gabgari/SHADOWBOT-codigo/docs/comandos-del-mando.pdf

# S H A D O W B O T

COMANDOS DEL MANDO · DUALSHOCK 4

Todos los botones, combinaciones y comandos por modo del mando de PS4 conectado al teléfono (Bluetooth o USB). La app los ejecuta y se los manda al carrito; no hay que cargar código en ninguna placa.

Cómo leer esta guía. L2 + botón = mantén L2 apretado y presiona el otro botón (combo). 2x = dos toques rápidos (menos de 0.4 s entre ellos). Los comandos solo funcionan después de presionar INICIAR en Conexiones; antes de eso el mando vibra y la bitácora dice "Bloqueado". El único que funciona siempre es PS = paro de emergencia. Los combos se pueden desactivar en la pantalla Mando › "Combos (L2 + botón)".

L1 no se usa. Está prohibido a propósito: no tiene ninguna función para evitar errores.

## 01 SIEMPRE (EN CUALQUIER MODO)

Botón | Qué hace
Stick izquierdo | Manejar el carrito (analógico: acelerar + girar). La velocidad tope es la misma del slider VELOCIDAD de la app.
Stick derecho | Mover el brazo de la cámara como torreta (PAN izquierda/derecha, TILT arriba/abajo), con arranque y frenado suaves.
PS | PARO DE EMERGENCIA: frena motores, corta bailes y escaneos. Destello rojo + vibración fuerte. Funciona aunque esté bloqueado.
Share | Tomar FOTO de la cámara principal (con su filtro). Destello blanco.
L2 + Share NUEVO | GRABAR / DETENER VIDEO. Graba la cámara principal, o las 2 cámaras juntas en un solo video si está activo 2 CAM en la consola.
Options | Entrar / salir de PANTALLA COMPLETA.
R3 (clic stick der.) | Centrar el brazo (a su posición 0).
L3 (clic stick izq.) | Escaneo panorámico con el brazo: izquierda, derecha y vuelve al centro.
2x R1 | Entrar al modo que se ve en el carrusel del menú.
2x R2 NUEVO | GIRO DE 360° sobre su propio eje (otra vez 2x R2 = cancelar). Usa los segundos por vuelta de Sistema › Exploración autónoma.
2x L2 (toques cortos) | Salir al MENÚ. Solo cuenta si no hiciste un combo con L2 de por medio.

## 02 COMBOS CON L2 MANTENIDO

L2 + Share NUEVO | Grabar / detener video (ver arriba).
L2 + ✕ | Faros: prender / apagar los 4 LEDs juntos.
L2 + ○ | Retroceso corto (0.6 s hacia atrás).
L2 + □ | Siguiente filtro de la cámara principal (Normal → IR → B/N → Verde → …).
L2 + △ | Analizar lo que ve la cámara principal con IA (Gemini).
L2 + ↑ | Brazo a la posición A (si está vacía, guarda ahí la posición actual).
L2 + → | Brazo a la posición B (vacía = la guarda).
L2 + ↓ | Brazo a la posición C (vacía = la guarda).
L2 + ← | Centrar el brazo.
L2 + R1 | Cambiar la cámara principal CAM 1 ↔ CAM 2.
L2 + R2 | Ir a la siguiente sección de la app (sale de pantalla completa si estaba abierta).
L2 + Options | Prender / apagar la luz del LCD 16x2 de CONTROL.
L2 + L3 | Bajar la velocidad del carrito 10 % (mínimo 10 %). Es la misma velocidad del slider de la app.
L2 + R3 | Subir la velocidad del carrito 10 % (máximo 100 %). Vibra más fuerte a más velocidad.

## 03 SEGÚN EL MODO DEL CARRITO

MENÚ (CARRUSEL)
← / → | Página anterior / siguiente del carrusel.
✕ | Entrar al modo que se ve.
- □ △ | LED 2, 3 y 4.
Stick izq. | El carrito también se maneja en el menú.
↑↑↓↓←→←→ ○ ✕ | Código secreto: MODO FIESTA (entra a DANCE con Everybody y luz de fiesta 22 s).

SPORT
✕ ○ □ △ | LED 1, 2, 3 y 4.
Stick izq. | Manejo tipo carrito RC, a la velocidad
| de la app.
Luz | Fuego que alterna | azul y | rojo.

EXPLORACIÓN (INSPECCIÓN)
✕ ○ □ △ | LED 1, 2, 3 y 4.
↑ / ↓ | Subir / bajar la velocidad de
EXPLORACIÓN (20–100 %, se ve en el LCD).
← / → | La cámara mira a la izquierda /
derecha.
R2 mantenido Modo preciso: 35 % de velocidad mientras lo aprietes.
Luz | Semáforo del gas MQ-2: | verde < 20
%, | amarillo 20–35 %, | rojo > 35 %
(vibra al entrar a rojo).

JUEGO / DANCE
✕ | Baile GIRO LOCO.
- Baile ZIGZAG.
□ | Baile SÍ Y NO.
△ | Baile TWIST.
← | Everybody (con música en el teléfono).
→ | Tokyo Drift (con música en el teléfono).
↓ | Parar el baile.

## 04 LUZ Y VIBRACIÓN DEL MANDO

Situación | Respuesta del mando
Por defecto | Fuego rojo animado (más vivo en SPORT y DANCE). En la pantalla Mando puedes elegir otro color, rojo fijo por modo o apagarla.
SPORT | Azul y rojo alternados (se desactiva con "SPORT en azul y rojo").
EXPLORACIÓN | Verde / amarillo / rojo según el MQ-2 (necesita la placa de sensores vinculada; se desactiva con "Luz según el gas").
Bailes | Vibra y destella en colores al ritmo de cada paso.
Al conectar | Destello rojo + vibración.
Cambio de modo | Destello + vibración corta.
Foto / Video | Destello blanco (foto) o rojo (video) + vibración.
Paro (PS) | Destello rojo largo + vibración fuerte.

## 05 AJUSTES EN LA PANTALLA MANDO

Ajuste | Para qué sirve
Velocidad del carrito | La misma velocidad de la app (también L2 + L3 / R3).
Zona muerta | Cuánto hay que mover los sticks antes de que respondan (5–30 %).
Velocidad brazo | Qué tan rápido se mueve el brazo con el stick derecho.
Invertir brazo | Stick derecho arriba/abajo al revés (como avión).
Vibración / Baile | Prender o apagar la vibración de avisos y la del ritmo de los bailes.
Luz del mando | Fuego rojo, rojo fijo por modo, apagada o fuego de un color.
| SHADOW BOT · BY GABGARI · COMANDOS DEL MANDO · OCTUBRE 2026
