gabgari/SHADOWBOT-codigo/docs/diagrama-de-conexiones.pdf

## A ESP32-S3 CONTROL · MOTORES, BRAZO Y LCD

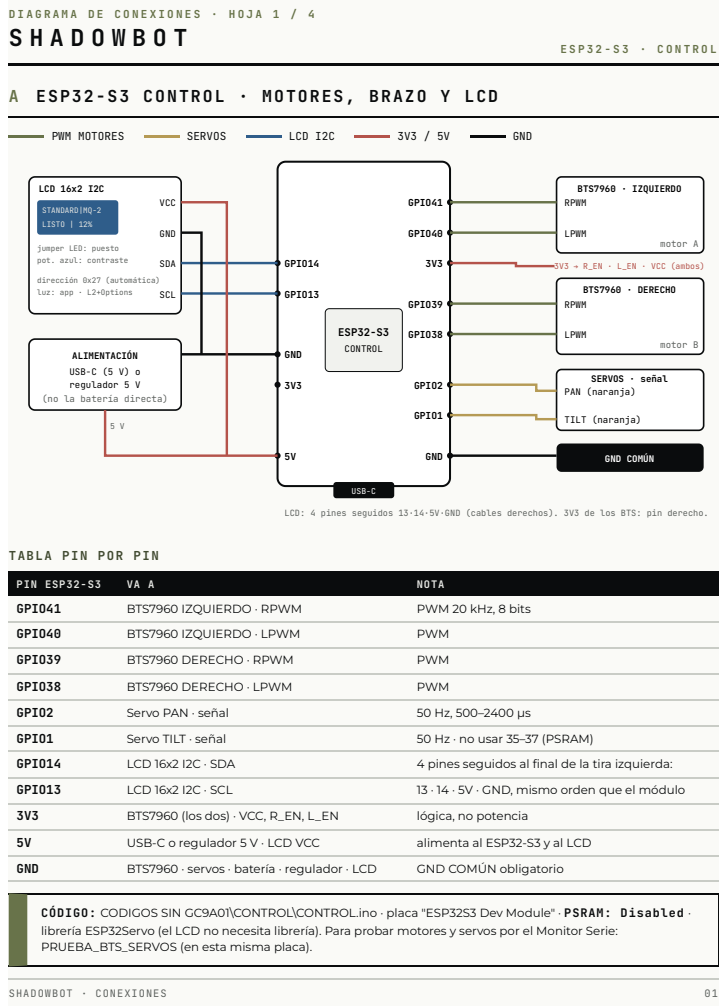
[picture p13: page 1]
PWM MOTORES; SERVOS; LCD I2C; GND; USB-C; ESP32-S3; CONTROL; GPIO14; GPIO13; GPIO41; GPIO40; GPIO39; GPIO38; GPIO2; GPIO1; LCD 16x2 I2C; STANDARD|MQ-2 LISTO | 12%; VCC; SDA; SCL; BTS7960 · IZQUIERDO RPWM; LPWM; motor A; BTS7960 · DERECHO RPWM; motor B; SERVOS · señal PAN (naranja); TILT (naranja); GND COMÚN; 3V3 → R_EN · L_EN · VCC (ambos); PIN ESP32-S3; NOTA; BTS7960 IZQUIERDO · RPWM; PWM 20 kHz, 8 bits; BTS7960 IZQUIERDO · LPWM; PWM; BTS7960 DERECHO · RPWM; BTS7960 DERECHO · LPWM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

jumper LED: puesto
pot. azul: contraste

dirección 0x27 (automática)
luz: app · L2+Options

ALIMENTACIÓN
USB-C (5 V) o
regulador 5 V
(no la batería directa)

LCD: 4 pines seguidos 13·14·5V·GND (cables derechos). 3V3 de los BTS: pin derecho.

TABLA PIN POR PIN

CÓDIGO: CODIGOS SIN GC9A01\CONTROL\CONTROL.ino · placa "ESP32S3 Dev Module" · PSRAM: Disabled ·
librería ESP32Servo (el LCD no necesita librería). Para probar motores y servos por el Monitor Serie:
PRUEBA_BTS_SERVOS (en esta misma placa).

## B ALIMENTACIÓN Y ETAPA DE POTENCIA

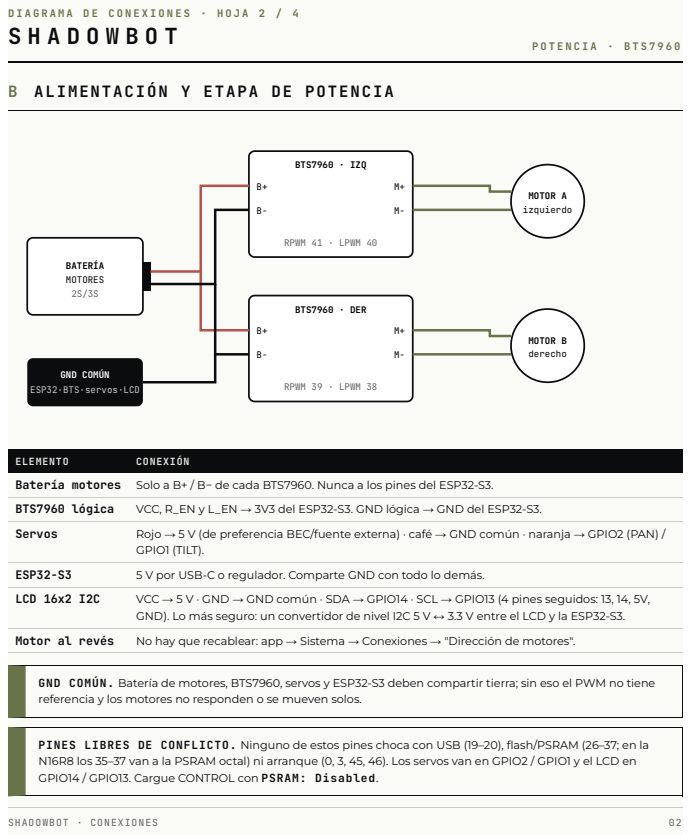
[picture p14: page 2]
BATERÍA MOTORES 2S/3S; BTS7960 · IZQ; RPWM 41 · LPWM 40; BTS7960 · DER; RPWM 39 · LPWM 38; MOTOR A izquierdo; MOTOR B derecho; ELEMENTO; CONEXIÓN; BTS7960 lógica; VCC, R_EN y L_EN → 3V3 del ESP32-S3. GND lógica → GND del ESP32-S3.; Servos; Rojo → 5 V (de preferencia BEC/fuente externa) · café → GND común · naranja → GPIO2 (PAN) /; GPIO1 (TILT).; ESP32-S3; 5 V por USB-C o regulador. Comparte GND con todo lo demás.; LCD 16x2 I2C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

GND COMÚN
ESP32·BTS·servos·LCD

Batería motores Solo a B+ / B− de cada BTS7960. Nunca a los pines del ESP32-S3.

GND). Lo más seguro: un convertidor de nivel I2C 5 V ↔ 3.3 V entre el LCD y la ESP32-S3.

GND COMÚN. Batería de motores, BTS7960, servos y ESP32-S3 deben compartir tierra; sin eso el PWM no tiene
referencia y los motores no responden o se mueven solos.

PINES LIBRES DE CONFLICTO. Ninguno de estos pines choca con USB (19–20), flash/PSRAM (26–37; en la
N16R8 los 35–37 van a la PSRAM octal) ni arranque (0, 3, 45, 46). Los servos van en GPIO2 / GPIO1 y el LCD en
GPIO14 / GPIO13. Cargue CONTROL con PSRAM: Disabled.

## C ESP8266 (NODEMCU / WEMOS) · MQ-2 Y 4 LEDS

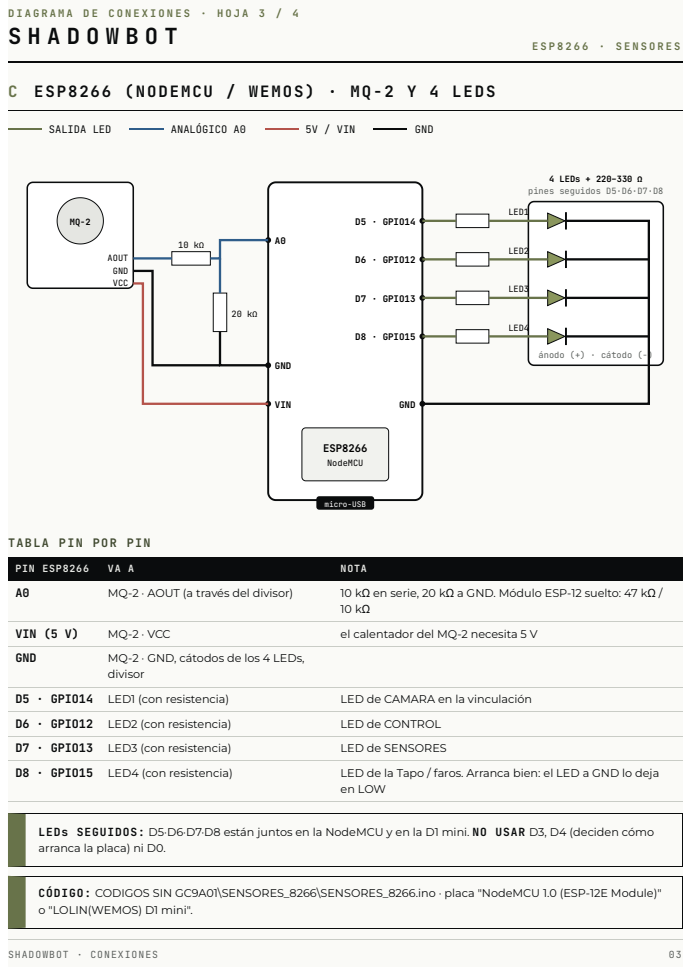
[picture p15: page 3]

TABLA PIN POR PIN

LEDs SEGUIDOS: D5·D6·D7·D8 están juntos en la NodeMCU y en la D1 mini. NO USAR D3, D4 (deciden cómo
arranca la placa) ni D0.

CÓDIGO: CODIGOS SIN GC9A01\SENSORES_8266\SENSORES_8266.ino · placa "NodeMCU 1.0 (ESP-12E Module)"
o "LOLIN(WEMOS) D1 mini".

D I A G R A M A D E C O N E X I O N E S · H O J A 4 / 4
S H A D O W B O T | E S P 3 2 - S 3 C A M · S I S T E M A

## D ESP32-S3 CAM · SOLO ALIMENTACIÓN

5V | GND

FUENTE 5 V
regulador / power bank
o USB-C de la placa
mín. 1 A

USB-C

OV2640 / OV3660

ESP32-S3
CAM

5V

GND

PINES DE LA CÁMARA
ya vienen conectados en la placa

XCLK 15 · PCLK 13
SDA 4 · SCL 5
VSYNC 6 · HREF 7
D0–D7: 11 9 8 10 12 18 17 16

No conectar nada
a esos pines.
PSRAM: OPI PSRAM (N8R8/N16R8)
PIN ESP32-S3 CAM | VA A | NOTA
5V | Fuente 5 V (o el USB-C) | la cámara + WiFi piden picos de corriente: fuente de 1 A o más
GND | GND de la fuente | si comparte la fuente con CONTROL, unir GND
Cámara | Conector FPC de la placa | cinta con los contactos hacia la placa, seguro bien cerrado

CÓDIGO: CODIGOS SIN GC9A01\CAMARA\CAMARA.ino · placa "ESP32S3 Dev Module" · PSRAM: OPI PSRAM · librería ArduinoJson. Al arrancar, el Monitor Serie (115200) dice "PSRAM: OK" o "PSRAM: NO encontrada"; la cámara funciona en los dos casos.

## E SISTEMA COMPLETO · 3 PLACAS

APP SHADOWBOT
tablet / celular

WiFi "001" · avisos UDP

ESP32-S3 · CONTROL
2x BTS7960 + 2 servos + LCD

ESP8266 · SENSORES
MQ-2 + 4 LEDs

ESP32-S3 CAM · CAMARA
video, fotos, Telegram

SIN CABLES ENTRE PLACAS. Las 3 placas se hablan solo por WiFi (red "001"). Lo único que se puede compartir es la fuente de 5 V y su GND.

SHADOWBOT · CONEXIONES · BY GABGARI | 04
